VAleSh-Soft/tda7439_audioprocessor/readme.md

## TDA7439_audioprocessor v 1.7

Модуль для работы с аудиопроцессором TDA7439, построенный на **Arduino Uno/nano/pro mini** (**ATmega168/328**)

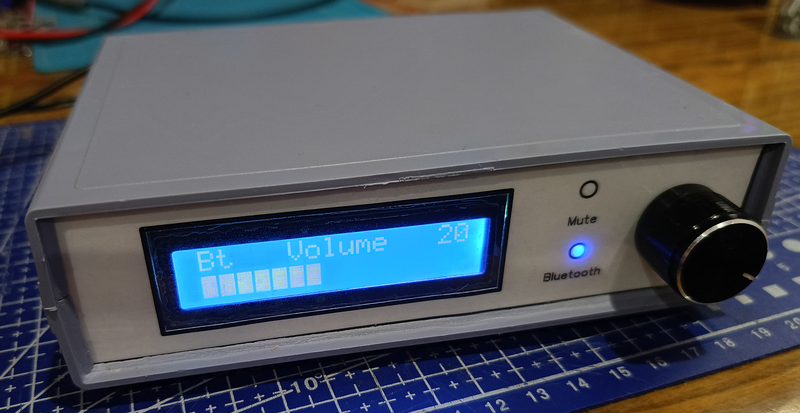
[picture p1: docs/002.png]


- [Описание TDA7439](#описание-tda7439)
- [Описание модуля](#описание-модуля)
  - [Индикация](#индикация)
  - [Управление](#управление)
- [Настройки прошивки](#настройки-прошивки)
  - [Шина I2C](#шина-i2c)
- [Используемые библиотеки](#используемые-библиотеки)

### Описание TDA7439

**TDA7439** – регулятор громкости и трехполосный регулятор тембра, разработанный для использования в HI-FI аппаратуре и качественных автомобильных аудиосистемах, обладает низким уровнем шумов и искажений.

Основные технические характеристики ИМС TDA7439 в этом модуле (некоторые параметры программно ограничены):

- Громкость 48 уровней от -47 до 0 дБ (0..47);
- Регулировка тембра НЧ, СЧ, ВЧ  ±14 дБ (с шагом 2 дБ, -7..7);
- Коммутация входов — 4 стерео канала;
- Предусиление от 0 до 30 дБ (с шагом 2 дБ, 0..14), независимое для каждого канала;
- Приглушение звука для входа от -14 до 0 дБ (ограничено программно);
  (*предусиление и приглушение регулируются одновременно в пределах -14..14*)
- Регулировка баланса ±28 дБ (с шагом 2 дБ, -14..14, ограниченно программно);
- Напряжение питания от 6 до 10,2 В (типовое значение 9 В);
- КНИ на частоте 1 кГц не более 0,01%;
- Управление осуществляется по шине **I2C**;

### Описание модуля

Модуль позволяет выбирать вход и настраивать параметры звука. Параметры громкости, тембра, баланса, приглушения и предусиления сохраняются для каждого входного канала в **EEPROM**.

Модуль позволяет указывать количество используемых входов, а так же позволяет использовать Bluetooth трансмиттер на любом из используемых входов.

#### Индикация

Модуль выводит данные на текстовый **LCD1602**-экран. Кроме того используется светодиод (красный) для индикации режима **MUTE** (мигает, если звук отключен), а так же, если ипользуется Bluetooth трансмиттер, светодиод для индикации его работы (синий, включается, если выбран канал с трансмиттером).

#### Управление

По умолчанию модуль управляется одним энкодером со встроенной кнопкой:

***Важно!!!** - при необходимости модуль позволяет подключить и использовать дополнительные кнопки - кнопку быстрого отключения звука, кнопку выбора режима экрана и кнопку переключения текущего входа*

- поворот рукоятки регулирует текущий параметр (по умолчанию регулируется громкость);
- клик кнопкой энкодера перебирает параметры для регулировки:
  - громкость (**Volume**);
  - тембр НЧ (**Bass**);
  - тембр СЧ (**Middle**);
  - тембр ВЧ (**treble**);
  - баланс (**Balance**);
- двойной клик кнопкой энкодера переводит модуль в режим настройки уровня предусиления входа (**InputGain**); позволяет как усилить, так и ослабить уровень звука канала;
- удержание нажатой кнопки энкодера отключает звук;
- поворот рукоятки с нажатой кнопкой энкодера позволяет выбрать текущий вход;

Внесенные изменения в настройки параметров сохраняются через две секунды после последней манипуляции энкодером/кнопками. После десяти секунд отсутствия активности пользователя модуль переходит в режим по умолчанию (регулировка громкости). Экран при этом гаснет (если задана опция `TURN_OFF_SCREEN_BACKLIGHT`);

Если экран отключен, любая манипуляция энкодером/кнопками сначала включает его, не изменяя настройки.

### Настройки прошивки

Все настройки собраны в начале файла **header_file.h**.

`#define NUMBER_OF_INPUT_IS_USED 4` - количество используемых входов; можно задать значение в интервале 1..4; если задать 0, компилятор выдаст ошибку, если задать более 4, все равно будут использоваться 4 входа (больше и нету);

`#define USE_BT_MODULE_ON_INPUT 4` - здесь указывается, на каком входе подключен Bluetooth трансмиттер; если задан канал с трансмиттером, модуль будет выводить на экран вместо номера канала сокращение **Bt**; кроме того, при выборе заданного входа будет включаться питание трансмиттера; если задать 0, трансмиттер использоваться не будет;

***Важно!!!** - питание Bt-модуля включается при первом переходе на вход, к которому он подключен; при переходе на другой вход питание Bt-модуля остается включенным, чтобы иметь возможность переключать входы TDA7439 без потери сигнала*

`#define USE_DEBUG_OUT 0` - включить вывод отладочной информации через интерфейс UART; 1 - включить, 0 - отключить;

`#define DEBUG_BAUD_COUNT 115200` - скорость работы UART-интерфейса;

`#define USE_MUTE_BUTTON 0` - использовать дополнительную кнопку для управления отключением звука; клик этой кнопкой дублирует удержание нажатой кнопки энкодера; 1 - использовать кнопку, 0 - не использовать;

`#define USE_MODE_BUTTON 0` - использовать кнопку для переключения режима управления - что в данный момент регулирует крутилка энкодера; клик и двойной клик дублируют таковые действия кнопки энкодера; 1 - использовать кнопку, 0 - не использовать;

`#define USE_INPUT_BUTTON 0` - использовать кнопку для переключения текущего входа; переключение идет по кругу от меньшего к большему; 1 - использовать кнопку, 0 - не использовать;

`#define TURN_OFF_SCREEN_BACKLIGHT 1` - отключать экран при возврате в режим по умолчанию; если установить 0, подсветка экрана отключаться не будет;

`constexpr uint32_t TIMEOUT_OF_RETURN_TO_DEFMODE = 10;` - таймаут возврата в режим по умолчанию при отсутствии активности пользователя в секундах;

`constexpr uint32_t TIMEOUT_OF_AUTOSAVE_DATA = 2;` - таймаут задержки сохранения параметров в **EEPROM**, в секундах;

`constexpr bool INT_PULLUP_OF_ROTARY_PINS = true;` - используется внутренняя подтяжка пинов к **VCC**, установите **false**, если ваш модуль энкодера использует внешнюю подтяжку;

Пины для подключения энкодера:
```
constexpr uint8_t ENC_A_PIN = 4;  - пин A энкодера (DT)
constexpr uint8_t ENC_B_PIN = 5;  - пин B энкодера (CLK)
constexpr uint8_t ENC_BUTTON_PIN = 3; - пин кнопки энкодера (SW)
```

`constexpr uint8_t BT_POWER_PIN = 6;` - пин для управления питанием Bluetooth трансмиттера;

`constexpr uint8_t BT_LED_PIN = 8;` - пин светодиода - индикатора включения Bluetooth трансмиттера;

`constexpr uint8_t MUTE_LED_PIN = 9;` - пин светодиода - индикатора режима **MUTE**;

`constexpr uint8_t VOLTAGE_CONTROL_PIN = 2;` - пин для контроля пропадания напряжения питания; используется для включения режима **MUTE** при отключении питания, чтобы избежать щелчка в колонках; так же блокируется запись в EEPROM для исключения порчи данных; для Atmega168/328 можно использовать пины 2 или 3; примерная схема подключения:

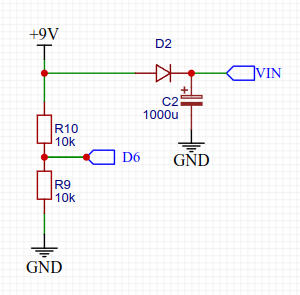
[picture p2: docs/001.png]


`constexpr uint8_t MUTE_BUTTON_PIN = 7;` - пин кнопки для отключения звука;

`constexpr uint8_t MODE_BUTTON_PIN = 10;` - пин кнопки для переключения режима управления;

`constexpr uint8_t INPUT_BUTTON_PIN = 11;` - пин кнопки для переключения входа;

`constexpr uint8_t BT_CONTROL_LEVEL = HIGH;` - управляющий уровень для включения питания Bluetooth трансмиттера;

`constexpr uint8_t I2CADDR_FOR_DISPLAY = 0x27;` - адрес экрана на шине I2C;

`constexpr uint16_t EEPROM_INDEX_FOR_INPUT = 11;` - индекс в EEPROM для сохранения текущего входа (1 байт)
`constexpr uint16_t EEPROM_INDEX_FOR_DATA_1 = 12;` - индекс в EEPROM для сохранения данных первого канала (6 байт)
`constexpr uint16_t EEPROM_INDEX_FOR_DATA_2 = 18;` - индекс в EEPROM для сохранения данных второго канала (6 байт)
`constexpr uint16_t EEPROM_INDEX_FOR_DATA_3 = 24;` - индекс в EEPROM для сохранения данных третьего канала (6 байт)
`constexpr uint16_t EEPROM_INDEX_FOR_DATA_4 = 30;` - индекс в EEPROM для сохранения данных четвертого канала (6 байт)

#### Шина I2C

Управление микросхемой **TAD7439** идет через шину **I2C**. Адрес микросхемы на шине - `0x44`. Используется интерфейс по умолчанию - **Wire**. Однако, если нужно использовать другой интерфейс, его можно задать в файле **header_file.h** в строке `#define TDA7439_I2C_PORT Wire`

***

### Используемые библиотеки

**Rotary.h** - https://github.com/brianlow/Rotary<br>
**LiquidCrystal_PCF8574.h** - https://github.com/mathertel/LiquidCrystal_PCF8574<br>
**shButton.h** - https://github.com/VAleSh-Soft/shButton<br>
**shTaskManager.h** - https://github.com/VAleSh-Soft/shTaskManager<br>
**shTDA7439.h** - https://github.com/VAleSh-Soft/shTDA7439<br>

***

Если возникнут вопросы, пишите на valesh-soft@yandex.ru
