VAleSh-Soft/tda7439_audioprocessor/docs/003.png

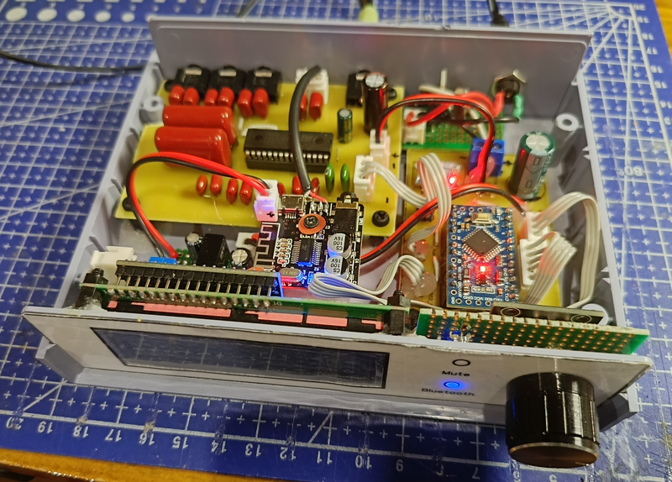
docs/003.png
