VAleSh-Soft/tda7439_audioprocessor/docs/mcu.png

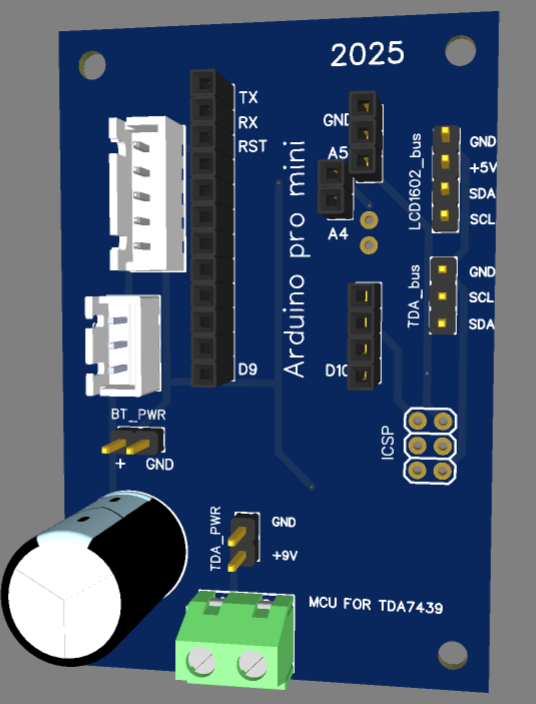
docs/mcu.png
