VAleSh-Soft/tda7439_audioprocessor/docs/Schematic_mcu.png

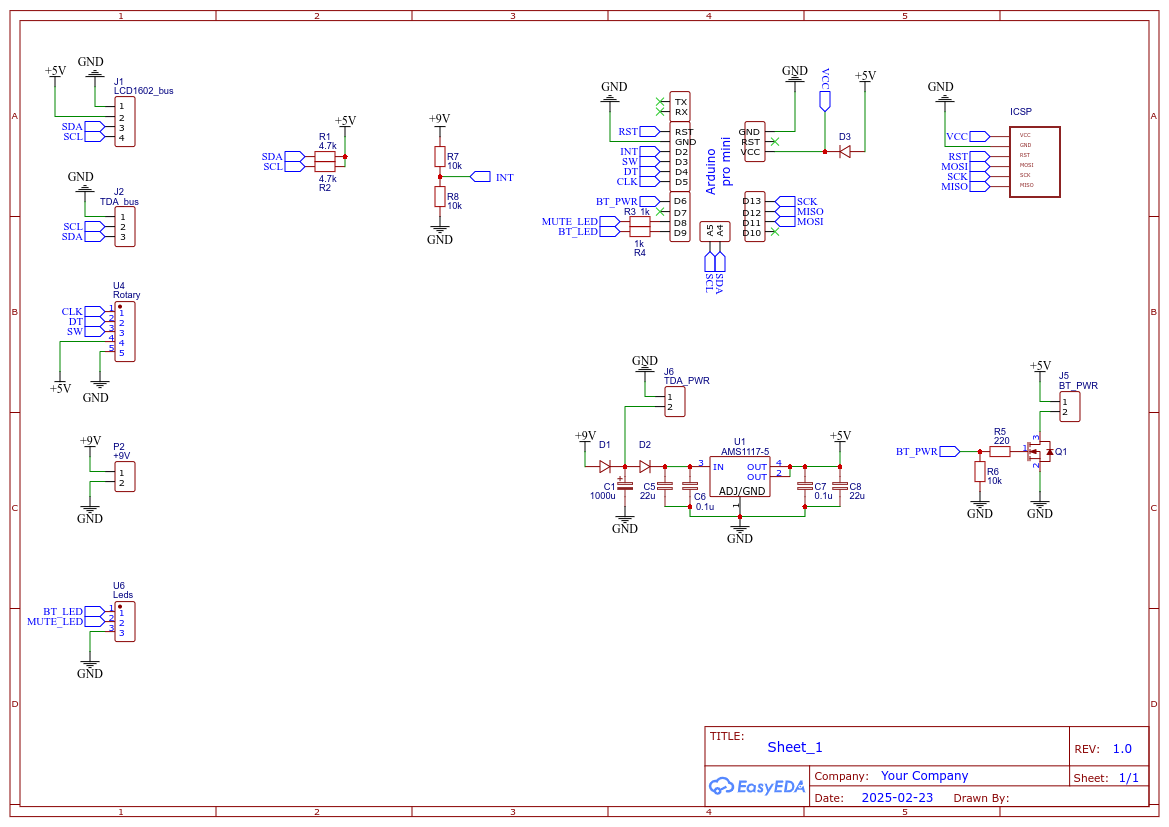
docs/Schematic_mcu.png
