VAleSh-Soft/tda7439_audioprocessor/docs/Schematic_tda7439.png

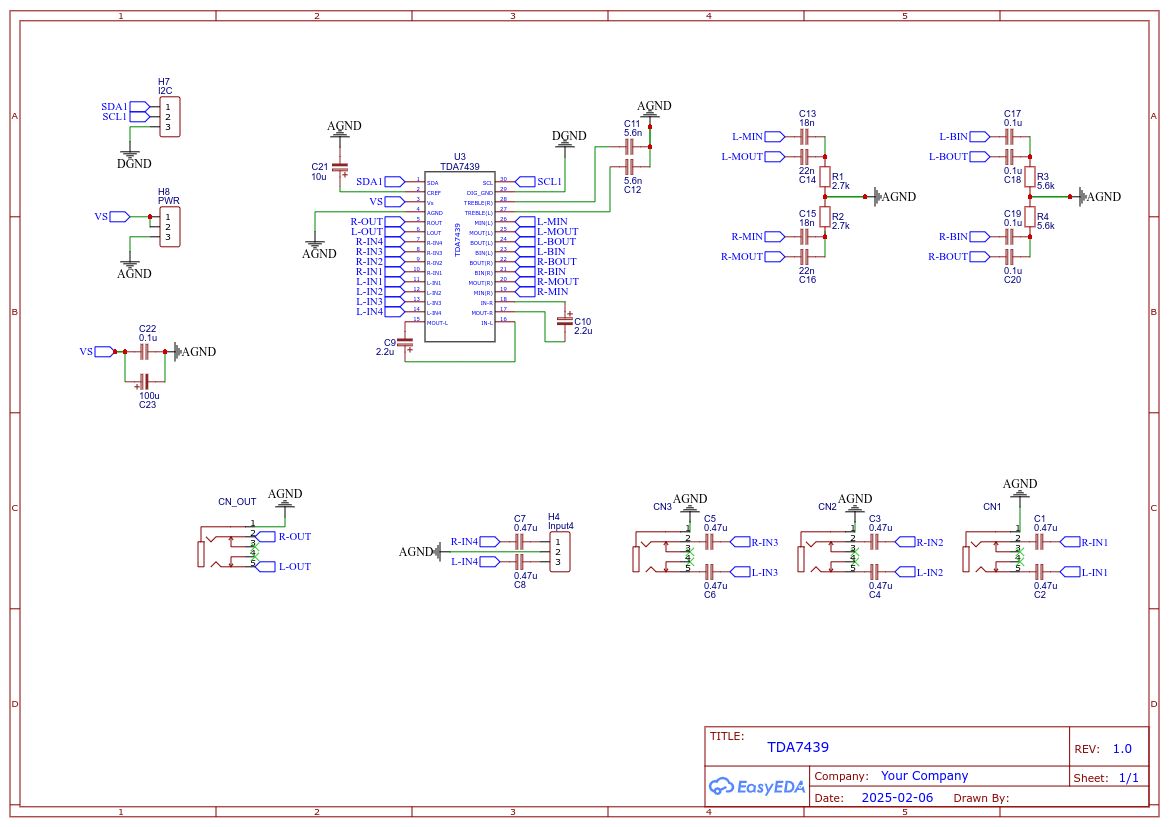
docs/Schematic_tda7439.png
