VAleSh-Soft/tda7439_audioprocessor/docs/tda7439.png

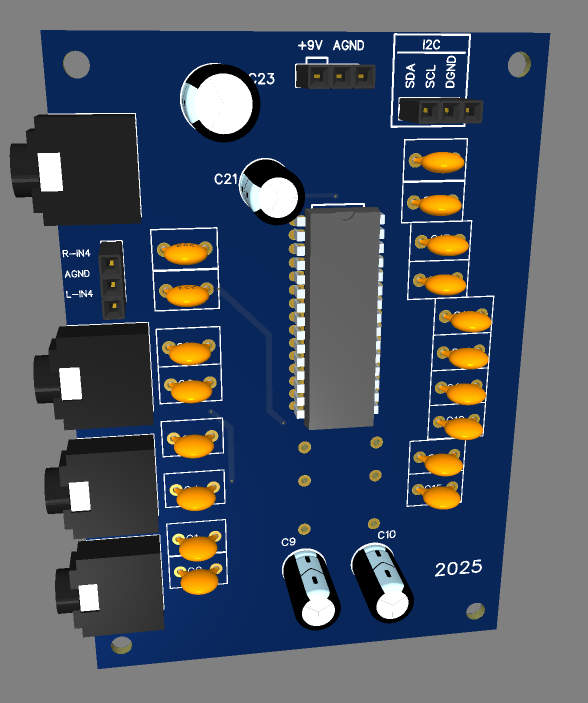
docs/tda7439.png
