VAleSh-Soft/tda7439_audioprocessor/tda.h

#ifndef TDA_H
#define TDA_H

#include <shTDA7439.h>
#include "header_file.h"

void tda_init()
{
  cur_mode = SET_VOLUME;
  tda.begin(&TDA7439_I2C_PORT);
  tda.mute();

  switchingInput(readCurInput(), true);
}

TDA7439_input readCurInput()
{
  uint8_t inp = read_eeprom_8(EEPROM_INDEX_FOR_INPUT);
  if (inp > 3 || inp < (4 - NUMBER_OF_INPUT_IS_USED))
  {
    inp = 3;
  }

  return (TDA7439_input)inp;
}

void setInputGain(int8_t _gain)
{
  if (_gain < 0)
  {
    tda.setSpeakerAtt((uint8_t)(_gain * -1));
    tda.setInputGain(0);
  }
  else
  {
    tda.setSpeakerAtt(0);
    tda.setInputGain((uint8_t)_gain);
  }
}

void setInputData(TDA7439_input _input)
{
  tda.mute();

  tda.setInput(_input);
  cur_input = _input;
  next_input = cur_input;
  write_eeprom_8(EEPROM_INDEX_FOR_INPUT, (uint8_t)cur_input);

  // считать данные канала из EEPROM
  readInputData(cur_data, cur_input);

  // передать данные в TDA7439
  tda.setTimbre(cur_data.bass, cur_data.middle, cur_data.treble);
  setInputGain(cur_data.input_gain);

  setBalance(cur_data.balance);

  TDA_PRINTLN(F("New input data for TDA7439"));
  TDA_PRINT(F("Input: "));
  TDA_PRINTLN(getInput(cur_input));
  TDA_PRINT(F("Volume: "));
  TDA_PRINTLN(cur_data.volume);
  TDA_PRINT(F("Bass: "));
  TDA_PRINTLN(cur_data.bass);
  TDA_PRINT(F("Middle: "));
  TDA_PRINTLN(cur_data.middle);
  TDA_PRINT(F("treble: "));
  TDA_PRINTLN(cur_data.treble);
  TDA_PRINT(F("Balance: "));
  TDA_PRINTLN(cur_data.balance);
  TDA_PRINT(F("Input att/gain: "));
  TDA_PRINTLN(cur_data.input_gain);
  TDA_PRINTLN();

  if (!mute_flag)
  {
    tda.setVolume(cur_data.volume);
  }
}

void setBalance(int8_t _balance)
{
  if (_balance > 14)
  {
    _balance = 14;
  }
  else if (_balance < -14)
  {
    _balance = -14;
  }

  tda.setBalance(_balance * 2);
}

void switchingInput(TDA7439_input _input, bool _init)
{
  new_input = false;
  if (_input != cur_input || _init)
  {
    if (!_init)
    {
      saveSettingsInEeprom();
    }

    TDA_PRINT(F("New input: "));
    TDA_PRINTLN(getInput(_input));

#if BT_MODULE_IS_USED
    // питание Bt-модуля включаем при первом переходе на вход, к
    // которому он подключен; при переходе на другой вход питание
    // Bt-модуля не выключаем, чтобы иметь возможность переключать
    // входы TDA7439 без потери сигнала
    if (_input == getInput(USE_BT_MODULE_ON_INPUT))
    {
      digitalWrite(BT_POWER_PIN, BT_CONTROL_LEVEL);
      TDA_PRINTLN(F("Bluetooth module is connected"));
    }
#endif
    setInputData(_input);
  }
  cur_mode = SET_VOLUME;
  printCurScreen();
}

#endif // TDA_H
